ResulTopal/Mei-v2-Autonomous-Watering-System/Mei v2 Autonomous Watering System/Images/PCB_3D_Mei_v2.png

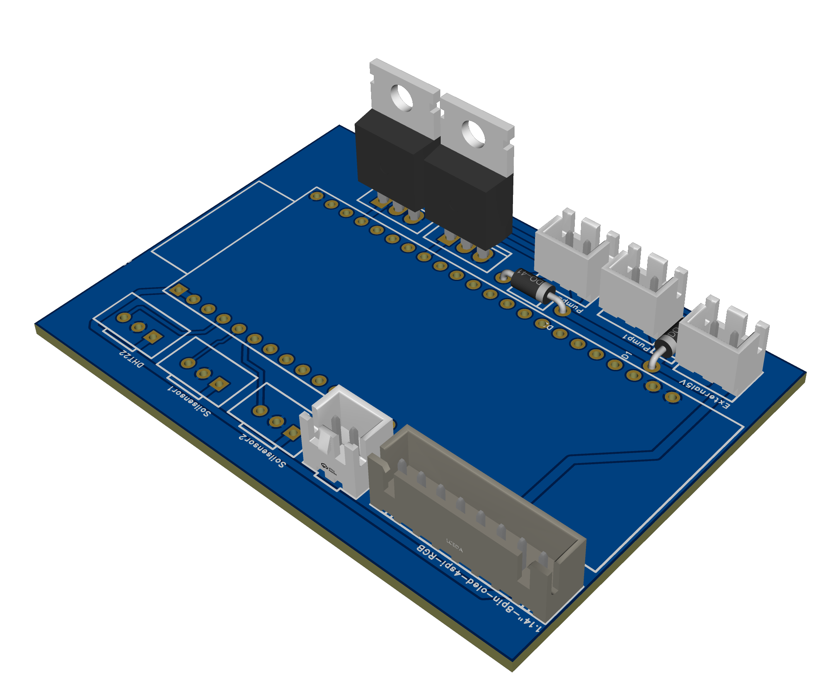
Mei v2 Autonomous Watering System/Images/PCB_3D_Mei_v2.png
