ResulTopal/Mei-v2-Autonomous-Watering-System/Mei v2 Autonomous Watering System/Hardware/BOM_Mei_v2.xlsx

No. | Quantity | Comment | Designator | Footprint | Value | Manufacturer Part | Manufacturer | Supplier Part | Supplier
1 | 1 | 1.14\"-8pin-oled-4spi-RGB | 1.14\"-8pin-oled-4spi-RGB | CONN-TH_8P-P2.54_XH2.54_C9900012080 |  | XH2.54-8 |  | C9900012080 | LCSC
2 | 2 | 1N4007 | D1,D2 | DO-41_BD2.4-L4.7-P8.70-D0.9-RD
3 | 1 | DHT22 | DHT22 | CONN-TH_3P-P2.50_HX-XHB2.54-3PZZ |  | HX-XHB2.54-3PZZ | hanxia(韩下) | C48641732 | LCSC
4 | 1 | External 5V | External5V | CONN-TH_2P-P2.50_HX-XHB2.54-2PZZ |  | HX-XHB2.54-2PZZ | hanxia(韩下) | C48641731 | LCSC
5 | 1 | Float | Float | CONN-TH_2P-P2.50_HX-XHB2.54-2PZZ |  | HX-XHB2.54-2PZZ | hanxia(韩下) | C48641731 | LCSC
6 | 2 | IRFZ44N | IRFZ44N,IRFZ44N | TO-220-3_L9.9-W4.5-P2.54-L |  | IRFZ44N | minos(迈诺斯) | C7429904 | LCSC
7 | 1 | Pump 1 | Pump1 | CONN-TH_2P-P2.50_HX-XHB2.54-2PZZ |  | HX-XHB2.54-2PZZ | hanxia(韩下) | C48641731 | LCSC
8 | 1 | Pump 2 | Pump2 | CONN-TH_2P-P2.50_HX-XHB2.54-2PZZ |  | HX-XHB2.54-2PZZ | hanxia(韩下) | C48641731 | LCSC
9 | 1 | Soil sensor 1 | Soilsensor1 | CONN-TH_3P-P2.50_HX-XHB2.54-3PZZ |  | HX-XHB2.54-3PZZ | hanxia(韩下) | C48641732 | LCSC
10 | 1 | Soil sensor 2 | Soilsensor2 | CONN-TH_3P-P2.50_HX-XHB2.54-3PZZ |  | HX-XHB2.54-3PZZ | hanxia(韩下) | C48641732 | LCSC
11 | 1 | ESP32 S3 DevKit | U2 | CONN-TH_ESP32-S3-DEVKITC-1U-N8 |  | ESP32-S3-DEVKITC-1-N8R8 | ESPRESSIF(乐鑫) | C20541519 | LCSC
