ResulTopal/Mei-v2-Autonomous-Watering-System/(list of files, drawings)

Other design files:
Mei v2 Autonomous Watering System/Hardware/Mei_v2_EasyEDA_Project.epro
